joaopspsps/glovarmonic/(commit log)

2024-12-13 glovarmonic.html: fix sending button colors not working correctly
2024-12-13 docs: jumper wires -> jump wires; add summary of prices section
